liulin-xt/-/README.md

# Analog Electronics Course Design: Audio Power Amplifier模电课设音频功率放大器
音频功率放大器设计
1.1设计要求 设计并制作用晶体管和集成运算放大器组成的音频功率放大电路，负载为扬声器，阻抗 8 欧姆。 1.2任务指标 频带宽 50HZ～20kHZ，输出波形基本不失真。 电路输出功率大于 8W。 输入灵敏度为 100mV。 输入阻抗不低于 47KΩ。
