liulin-xt/-/(list of files, drawings)

Other design files:
PCB_模电_2025-09-03.pcbdoc
原理图_模电_2025-09-03.schdoc
电路原理图.ms14
